Rosnel14/Anura-Headphones/README.md

# Anura Headphones 
Noise Cancelling headphones for frogs, (and humans). 
Here you'll find all the design files for this project and our final report! 

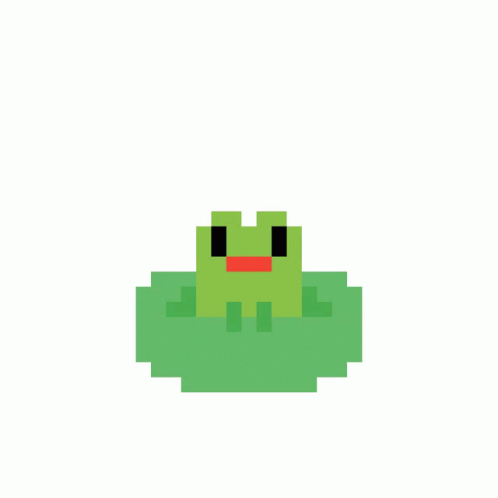
[picture p1: funny/frog.gif]
