Rosnel14/Anura-Headphones/diagrams/Anura_Electrical_System-Analog_ANC.drawio.png

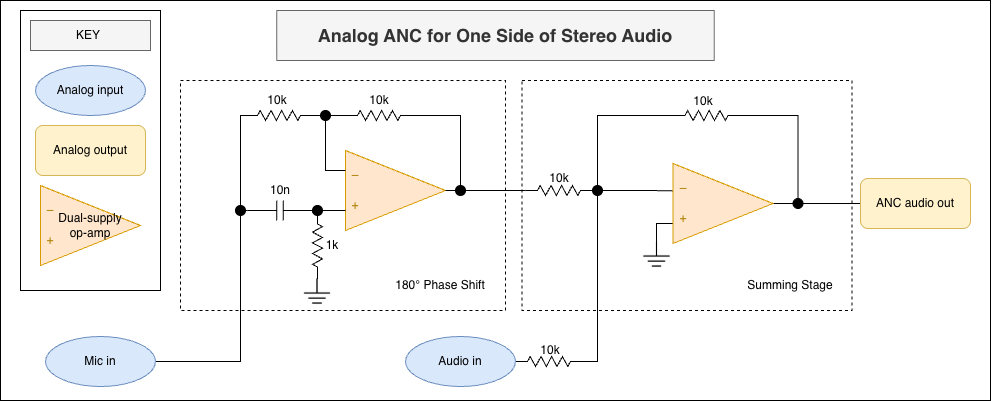
diagrams/Anura_Electrical_System-Analog_ANC.drawio.png
