Rosnel14/Anura-Headphones/diagrams/Anura_Electrical_System-Live_Translation.drawio.png

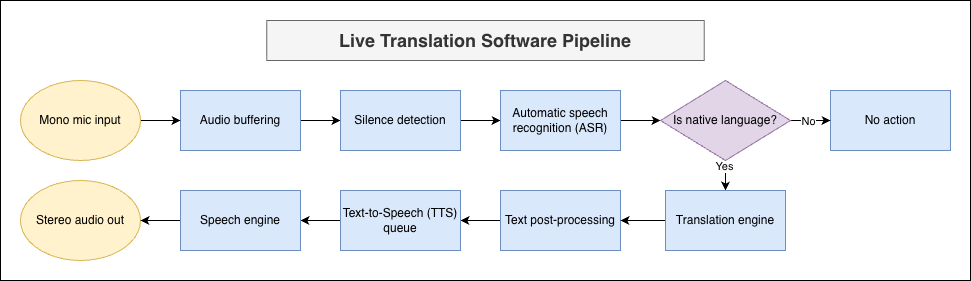
diagrams/Anura_Electrical_System-Live_Translation.drawio.png
