Rosnel14/Anura-Headphones/diagrams/Anura_Electrical_System.drawio.png

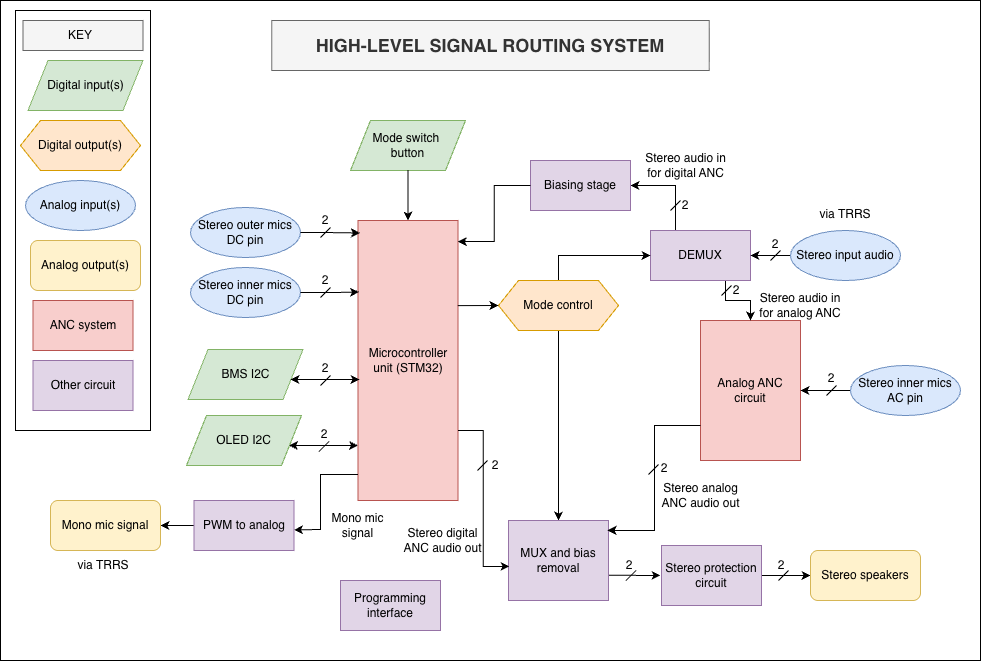
diagrams/Anura_Electrical_System.drawio.png
