Rosnel14/Anura-Headphones/enclosure-wiring-documentation/headphone_dimensions_draft5.dxf

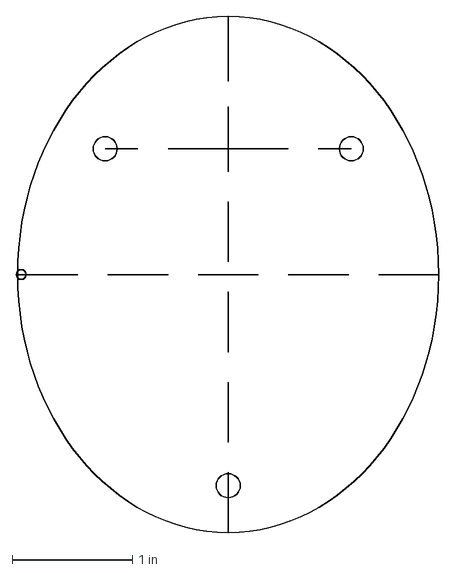
[picture p5: CAD file, 2026-03-31]
enclosure-wiring-documentation/headphone_dimensions_draft5.dxf
3.51 x 4.29 in
