Rosnel14/Anura-Headphones/enclosure-wiring-documentation/headphone_dimensions_draft3.dxf

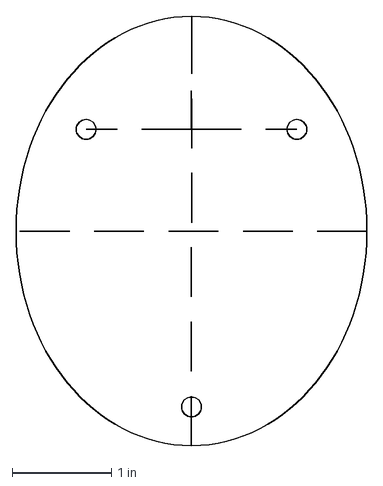
[picture p6: CAD file, 2026-03-31]
enclosure-wiring-documentation/headphone_dimensions_draft3.dxf
3.54 x 4.33 in
