Rosnel14/Anura-Headphones/enclosure-wiring-documentation/headphone_dimensions_draft7.dxf

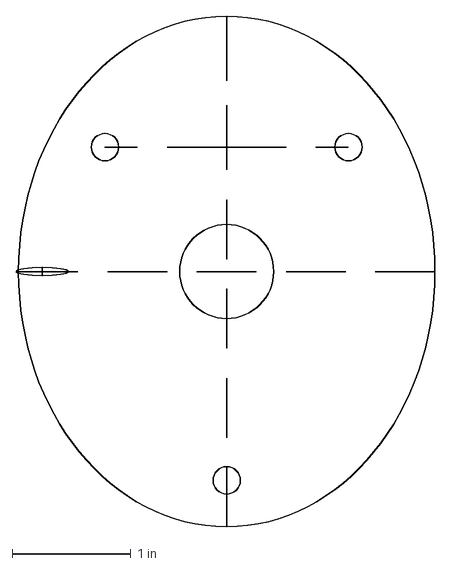
[picture p9: CAD file, 2026-03-31]
enclosure-wiring-documentation/headphone_dimensions_draft7.dxf
3.52 x 4.29 in
