Rosnel14/Anura-Headphones/enclosure-wiring-documentation/headphone_dimensions_draft8.dxf

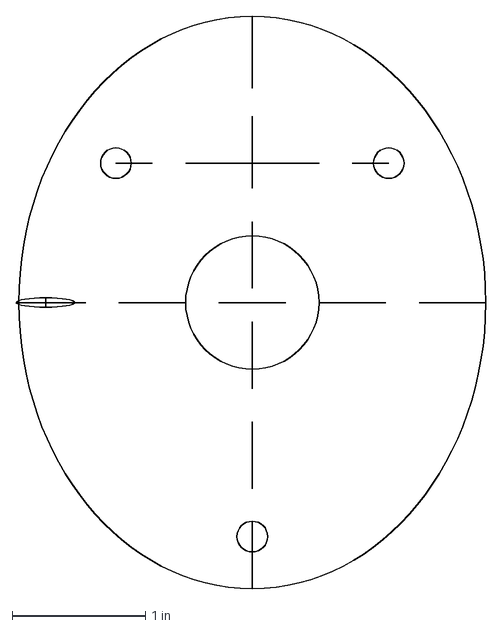
[picture p10: CAD file, 2026-03-31]
enclosure-wiring-documentation/headphone_dimensions_draft8.dxf
3.52 x 4.29 in
