Rosnel14/Anura-Headphones/enclosure-wiring-documentation/headphone_dimensions_draft2.dxf

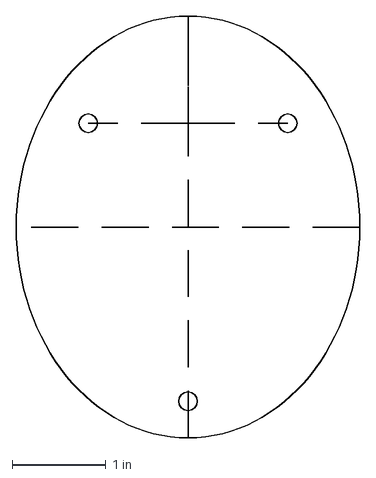
[picture p11: CAD file, 2026-03-30]
enclosure-wiring-documentation/headphone_dimensions_draft2.dxf
3.66 x 4.49 in
