Rosnel14/Anura-Headphones/Spice-Simulations/AllPass_Test.asc

C1: cap; 10n
M1: nmos; cd4007
R1: res; 10k
R2: res; 10k
R3: res; 1k
U1: opamp2; LF356/NS
V1: voltage; 5
V2: voltage; 5
V3: voltage; SINE(0 1 10k); AC 1
V4: voltage; pulse(0 5 0 1u 1u 5m 10m)
Named nets: 0, VSS, VDD, out, in
.ac dec 1000 10 10k
.inc LF356.MOD
.model cd4007 nmos(kp=1m vt0=1.5)
.tran 1
