Rosnel14/Anura-Headphones/Spice-Simulations/AnalogANC.asc

C1: cap; 1µ
C2: cap; 33n
C3: cap; 10n
C4: cap; 33n
C5: cap; 250µ
R1: res; 10
R2: res; 60
R3: res; 1k
R4: res; 10k
R5: res; 10k
R6: res; 1k
R7: res; 10k
R8: res; 10k
R9: res; 10k
U2: opamp2; LF356/NS
U3: opamp2; LF356/NS
U5: Lm386
V1: voltage; 5
V2: voltage; 5
V3: voltage; SINE(0 200m 60)
V4: voltage; pulse(0 3.3 0 1u 1u 5m 10m)
V5: voltage; 0
V6: voltage; SINE(0 300m 444)
Named nets: 0, VSS, VDD, Allp_out, audio_in, noise, power_in, speaker_in, power_prefilter, bit0, bit1
.inc LF356.MOD
.tran 0 5 0 1m
Power Amplifier Stage
simulated acoustic noise with audio input being modulated with noise
Sim Commands
180 Phase Shift
Need to validate with destructive interference of sine wave, see sim.
Summing Amplifier
input from mic
MUST HAVE PRE-AMP
speaker 
impedance
Power
Noise Signal
Audio Input
