Rosnel14/Anura-Headphones/Spice-Simulations/PowerAmplifier.asc

C1: cap; 33n
C2: cap; 33n
C6: cap; 1µ
C7: cap; 100µ
L1: ind; 10m
R1: res; 10
R2: res; 30
U1: Lm386
V1: voltage; SINE(0 1 444); AC 1
V2: voltage; 5
V3: voltage; 5
Named nets: 0, VDD, VSS, in, out
.tran 1
.ac dec 1000 20 100k
.four 444Hz V(in) V(out)
