Rosnel14/Anura-Headphones/enclosure-wiring-documentation/original_manufacturer_headphone_setup.png

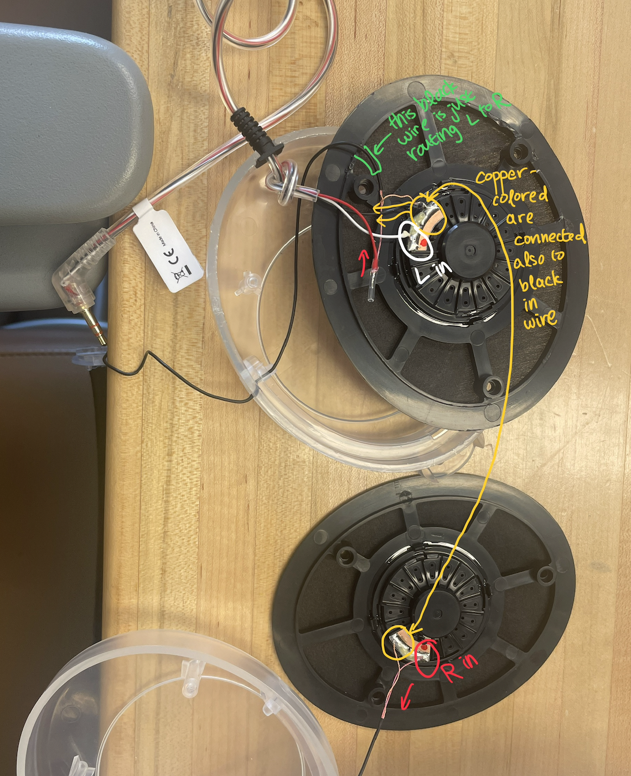
enclosure-wiring-documentation/original_manufacturer_headphone_setup.png
