Rosnel14/Anura-Headphones/TODO.md

### TODO ###

## 3/22/26

If we use an external app:

Currently, headphones come with TRS setup. Proposal:
1. Slice clear wire encasing
2. Wire fourth wire through extra space. May need to just forego casing protecting but could put around later just externally (but not going into the enclosure)
3. Connect four wires to new TRRS connector

Worst case can also just use computer mics

We should also set STM32 up with connection to external memory just in case we want to program locally and store language translations directly on the headphones... on second thought I'm pretty convinced we should just communicate directly w app
