Rosnel14/Anura-Headphones/(commit log)

2026-02-14 power amp circuit ready irl
2026-02-15 fft and THD calc for power amp
2026-03-22 this is a trs cable
2026-03-30 draft 2 dimensions
    [headphone_dimensions_draft2.dxf]
2026-03-31 draft 8 has accurate working dimensions
    [headphone_dimensions_draft3.dxf, headphone_dimensions_draft4.dxf, headphone_dimensions_draft5.dxf, headphone_dimensions_draft6.dxf, headphone_dimensions_draft7.dxf, headphone_dimensions_draft8.dxf]
2026-04-25 trrs wiring:
